ssfivy/sion/(list of files, drawings)

Other design files:
hardware/can.SchDoc
hardware/can_transciever_dualvolt_isolated.SchDoc
hardware/can_transciever_isolated.SchDoc
hardware/endpanel_back.PcbDoc
hardware/endpanel_front.PcbDoc
hardware/ethernet.SchDoc
hardware/Expansion.SchDoc
hardware/gumstix.PcbLib
hardware/gumstix.SchLib
hardware/Gumstix_Overo.SchDoc
hardware/lol_autorouter.PcbDoc
hardware/LPC1768.SchDoc
hardware/powertrain.SchDoc
hardware/pwrmeas.SchDoc
hardware/SDCard_SPI.SchDoc
hardware/sepic.SchDoc
hardware/sepic.SchLib
hardware/sion.PcbDoc
hardware/sion.PcbLib
hardware/sion.PrjPcb
hardware/sion.SchLib
hardware/sion_os.PrjPcb
hardware/sja1000.SCHDOC
hardware/supercap.SchDoc
hardware/toplevel.SchDoc
hardware/toplevel_os.SchDoc
hardware/usb_isolated_uart_x2.SchDoc
hardware/USB_Serial_Isolated.SchDoc
hardware/wifi_isolated.SchDoc
hardware/wifi_isolated_uart.SchDoc
hardware/wifi_isolated_uart_old.SchDoc
