ssfivy/sion/software/sion_can/include/project/itoa.h

/** \file itoa.h
 * \brief header for itoa.c
 * \author Freddie Chopin
 * \date 2009-04-02
 */

/******************************************************************************
* project: 750-750
* chip: STM32F103VB
* compiler: arm-none-eabi-gcc 4.4.1
******************************************************************************/

#ifndef ITOA_H_
#define ITOA_H_

/*
+=============================================================================+
| global definitions
+=============================================================================+
*/

/*
+=============================================================================+
| strange variables
+=============================================================================+
*/

/*
+=============================================================================+
| global variables
+=============================================================================+
*/

/*
+=============================================================================+
| global functions' declarations
+=============================================================================+
*/

char* itoa(int value, char* buffer, int base);

/******************************************************************************
* END OF FILE
******************************************************************************/
#endif /* ITOA_H_ */
