ssfivy/sion/(commit log)

2011-08-31 added sion files to its own repo
    [Expansion.SchDoc, Gumstix_Overo.SchDoc, LPC1768.SchDoc, SDCard_SPI.SchDoc, USB_Serial_Isolated.SchDoc, can.SchDoc, can_transciever_dualvolt_isolated.SchDoc, can_transciever_isolated.SchDoc]
2011-08-31 Routed all power sections, LED, and JTAG. Next is USB
    [sion.PcbDoc, sion_os.PrjPcb]
2011-09-01 More routing. USB finished. LPC almost done.
    [sion.PcbDoc]
2011-09-02 More routings...
    [sion.PcbDoc]
2011-09-04 More routing, 90% done. Moved voltage sensing to LPC.
    [can.SchDoc, can_transciever_dualvolt_isolated.SchDoc, powertrain.SchDoc, sion.PcbDoc, sion_os.PrjPcb, toplevel_os.SchDoc]
2011-09-05 Routing complete. Ready for inspection.
    [endpanel_back.PcbDoc, endpanel_front.PcbDoc, sion.PcbDoc, sion_os.PrjPcb]
2011-09-11 Ooops, forgot ground plane, ooops
    [sion.PcbDoc]
2011-09-21 Turns out the no delay was because packets was not getting sent. Fixed that by stuffing multiple packets inside a frame. Need dynamic frame size algorithm.
    [sion_can.c, socket.c, socket.h]
2011-09-21 Fixed circ buffer, added output messages. SQL Logging enabled on both sion and ciel. Near-ready software, good enough for friday test.
    [sion_can.c, sion_can.h, sionconfig.h, socket.c, socket.h]
2011-09-22 re-enabled text log and scanalysis socket
2011-09-23 Fixed telemetry bug where large timestamps overwrite values.
    [sion_can.c]
2011-09-24 Fixed translation bug. Linker should be told the correct architectures.
    [sion_can.c, tritium-can.h]
2011-09-24 Tritium packet translation for WS22 *should* be completed. Minus timestamp. That requires some timer meddling and timesync detection.
